jeremy-daily/TU-TeensyIMUwithCAN/README.md

# TU-TeensyIMUwithCAN
This project was to build a small breakout board for the Teensy 3.2 that could gather accelerometer data and interface with a CAN network. The sensing circuits is the Bosch Sensortech BNO055 and the Analog Devices ADXL377 high G accelerometer.
