jeremy-daily/TU-TeensyIMUwithCAN/Calibrations/Unit 001.xlsx

Name | X uG | X ADC | Y G | Y ADC | Z G | Z ADC
USB Down | 1000000 | 32952.02694 | 0 | 32837.47375 | 0 | 32789.69776
USB Up | -1000000 | 32605.43824 | 0 | 32845.82713 | 0 | 32814.75188
Upside down | 0 | 32777.23686 | 0 | 32857.92915 | -1000000 | 32666.67814
Flat/Normal | 0 | 32771.48715 | 0 | 32833.2968 | 1000000 | 32963.45378
Right Side | 0 | 32759.49206 | -1000000 | 32651.46593 | 0 | 32776.28259
Left | 0 | 32772.91463 | 1000000 | 32978.57917 | 0 | 32830.07589
+200 x | 199900000 | 65536 | 199900000 | 65536 | 199900000 | 65536
-200 x | -200000000 | 0 | -200000000 | 0 | -200000000 | 0
Slope |  | 5744.858432 |  | 6101.96963 |  | 6451.176237
zero |  | 32770.28268 |  | 32843.63171 |  | 32802.70203
Sample | 25000 | -44.63917396 | 25000 | -47.86160246 | 25000 | -50.33660592
Max Value | 65536 | 3.3 | 3.08 | 61166.93333
Mid range | 32768 | this should be zero
