jeremy-daily/TU-TeensyIMUwithCAN/(list of files, drawings)

Other design files:
Hardware and Schematics/TeensyIMU.PcbDoc
Hardware and Schematics/TeensyIMU.PrjPcb
Hardware and Schematics/TeensyIMULite.SchDoc
