jeremy-daily/TU-TeensyIMUwithCAN/(commit log)

2016-04-28 Logging at 4000Hz to SD card
    Based on Arduino examples for LowLatencyLogging in the SDFAT examples.
    Also used the ADC Timed Interval Logging as inspiration.
2016-04-29 Added recording switch
2016-04-29 Automatic Logging with External Jumper
    This commit has LowLatencyLogger ready for acquiring High G
    accelerometer data.
2016-05-02 Create circular buffer
    Single file writes
    [Unit 001.xlsx]
2016-05-08 Working 1000 Hz logger
    Used Adafruit Libraries
2016-05-08 Broken
    Data is garbled
    [LowLatencyLogger.ino]
2016-05-11 Added Hardware Schematics
    [TeensyIMU.PcbDoc, TeensyIMU.PrjPcb, TeensyIMULite.SchDoc]
2016-08-30 Initial commit for the example program for Vibrations class
    [BNO055.h, Vibrations_IntroToSampling.ino]
2016-08-30 Sketch produces readings for class now
    Made sure the Vibrations class can get data out of the sensor.
    [BNO055.h, Vibrations_IntroToSampling.ino]
2016-08-31 Used the Adafruit Libraries
    In file \Arduino\libraries\Adafruit_BNO055\Adafruit_BNO055.h on line 33
    change the word “Wire” to “i2c_t3”
